semianalog/xmega-au-dev/renders/B_Cu.png

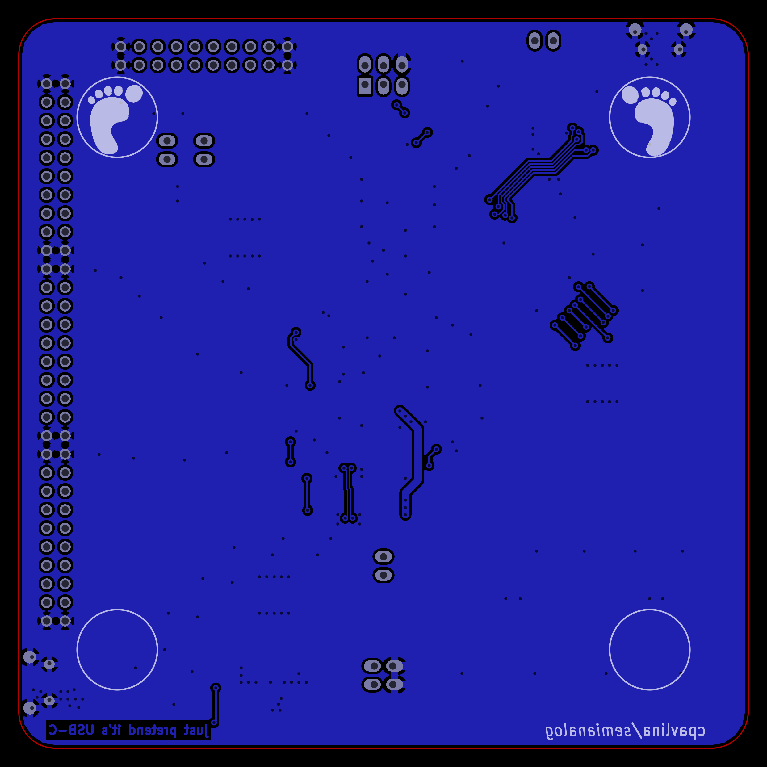
renders/B_Cu.png
