semianalog/xmega-au-dev/renders/F_Cu.png

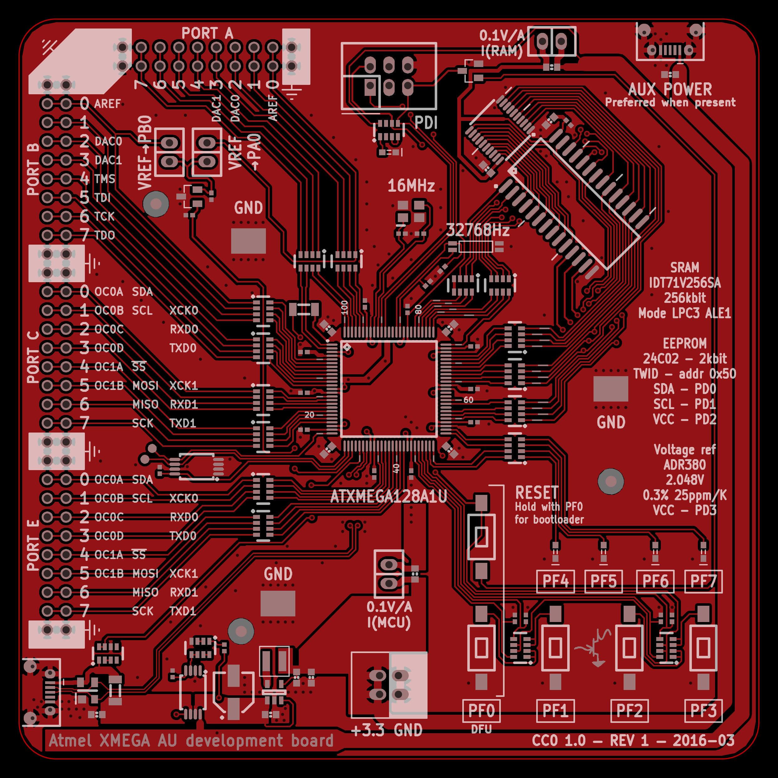
renders/F_Cu.png
