semianalog/xmega-au-dev/renders/Overview.png

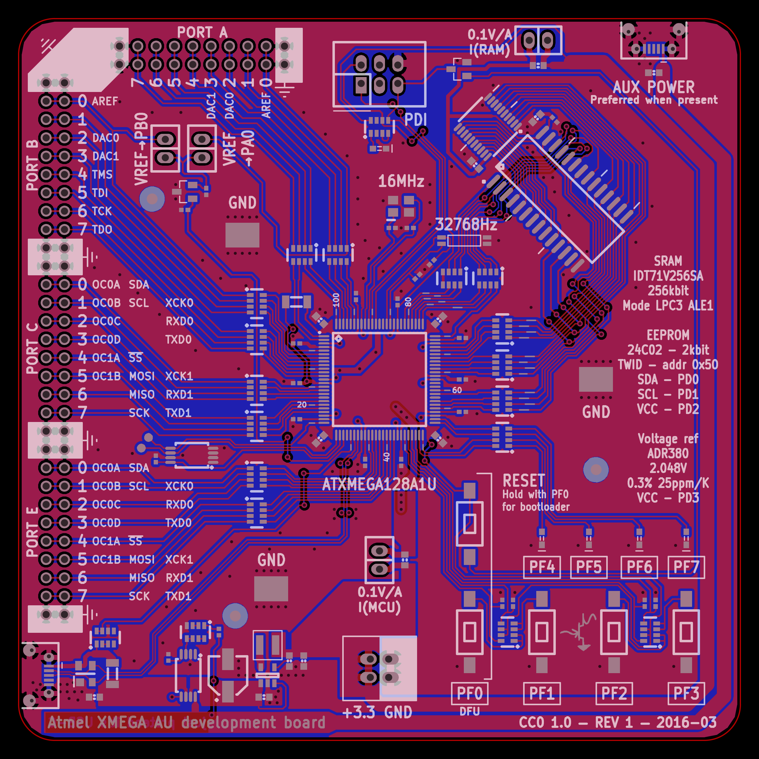
renders/Overview.png
