semianalog/xmega-au-dev/renders/Assembly.png

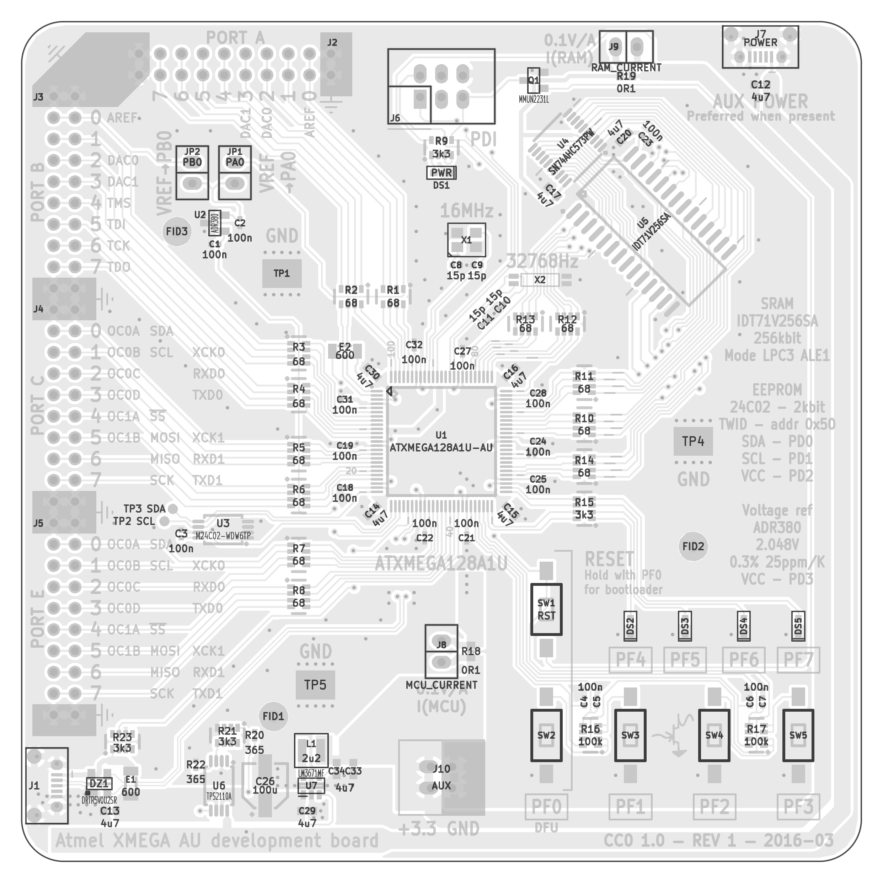
renders/Assembly.png
