semianalog/xmega-au-dev/renders/schematic.pdf

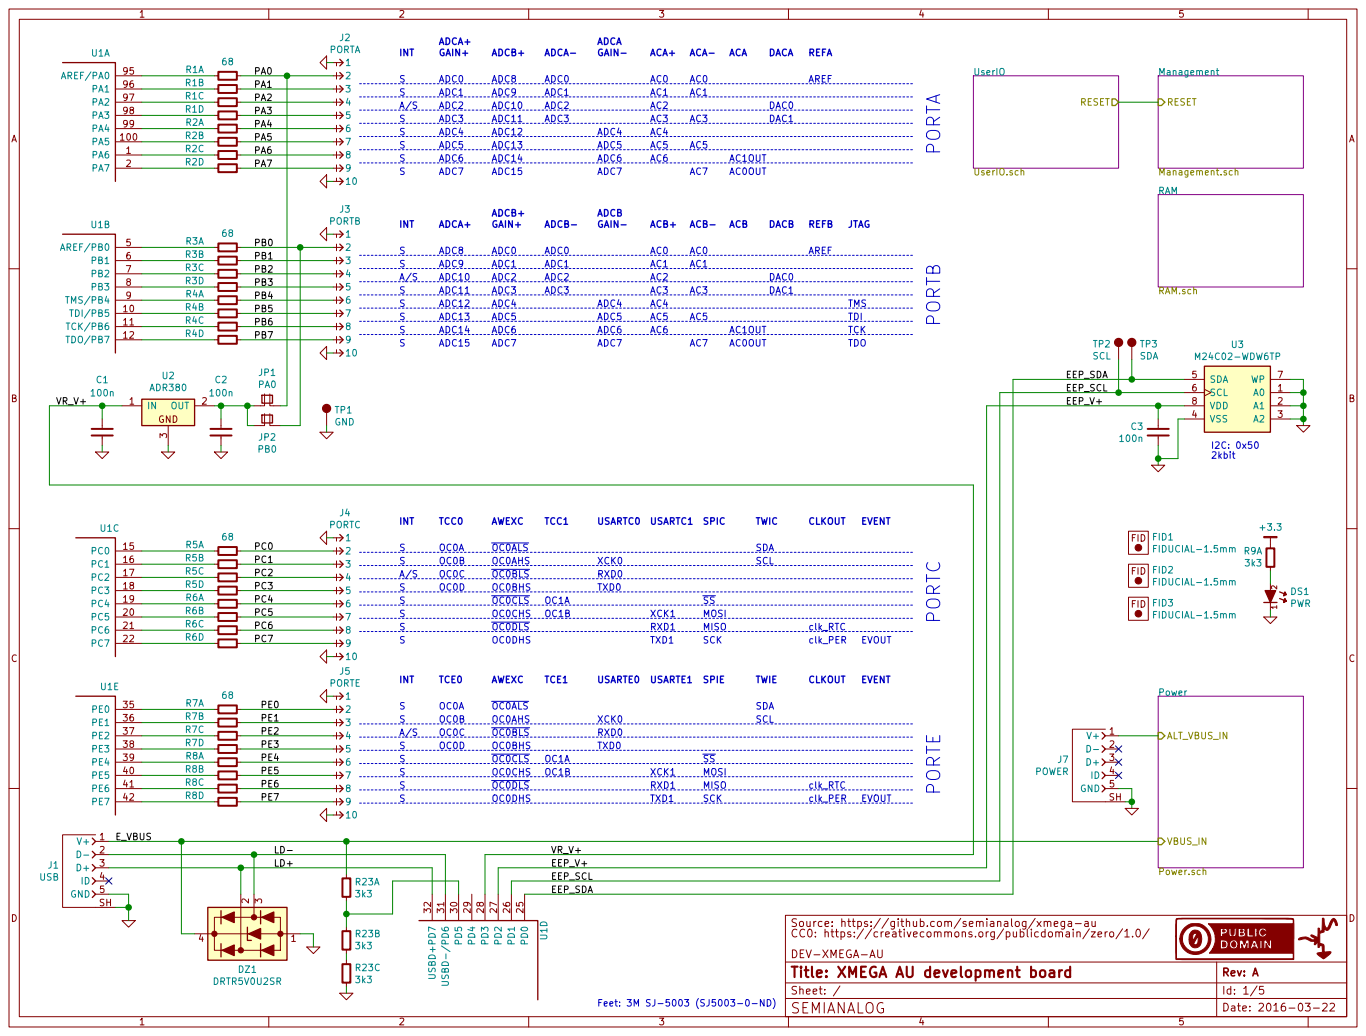
[picture p5: page 1]

Source: https://github.com/semianalog/xmega-au

Sheet: / DEV-XMEGA-AU

Id: 1/5 Title: XMEGA AU development board

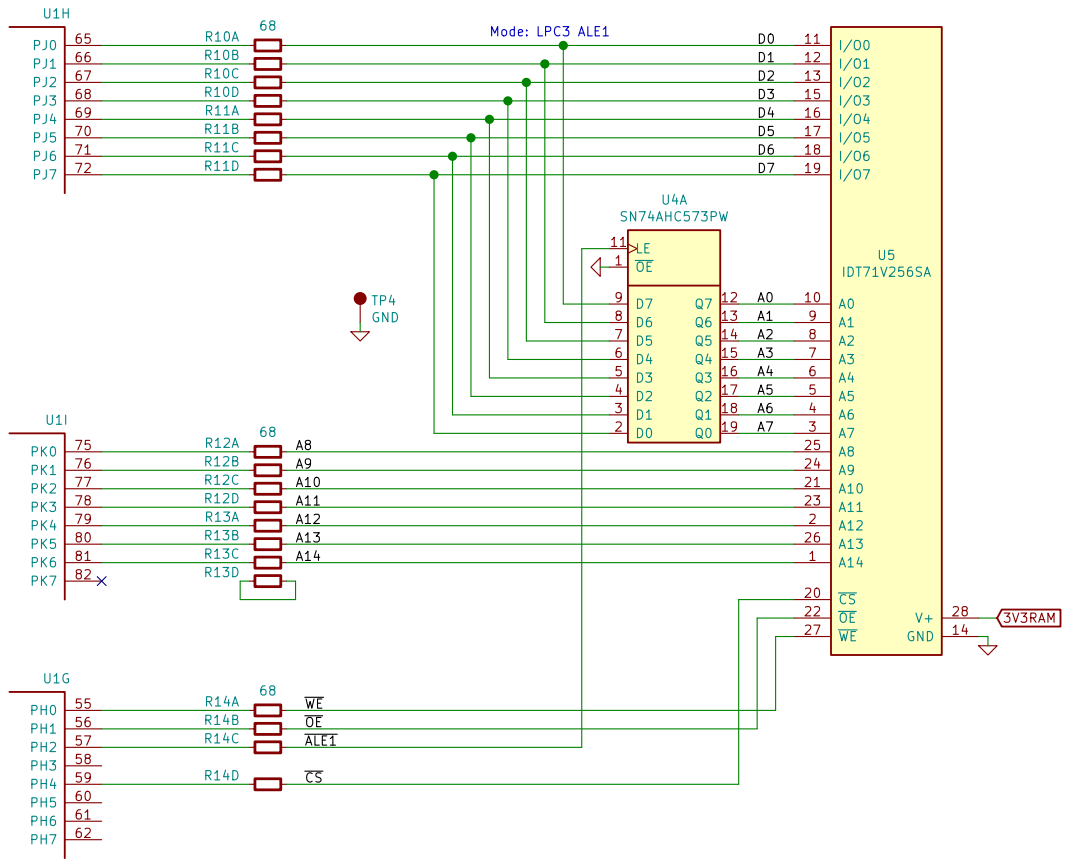
[picture p6: page 2]

Source: https://github.com/semianalog/xmega-au

Sheet: /RAM/ DEV-XMEGA-AU

Id: 2/5 Title: XMEGA AU development board

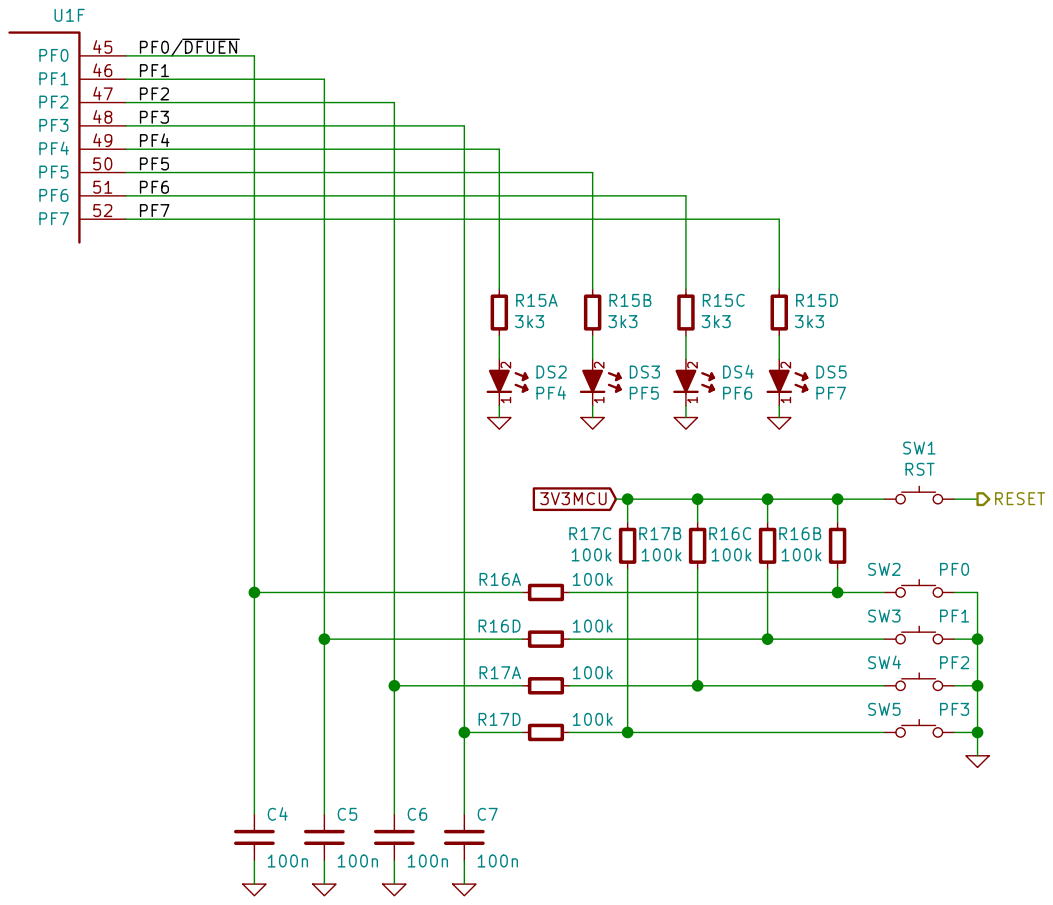
[picture p7: page 3]

Source: https://github.com/semianalog/xmega-au CC0: https://creativecommons.org/publicdomain/zero/1.0/

Sheet: /UserIO/ DEV-XMEGA-AU

Id: 3/5 Title: XMEGA AU development board

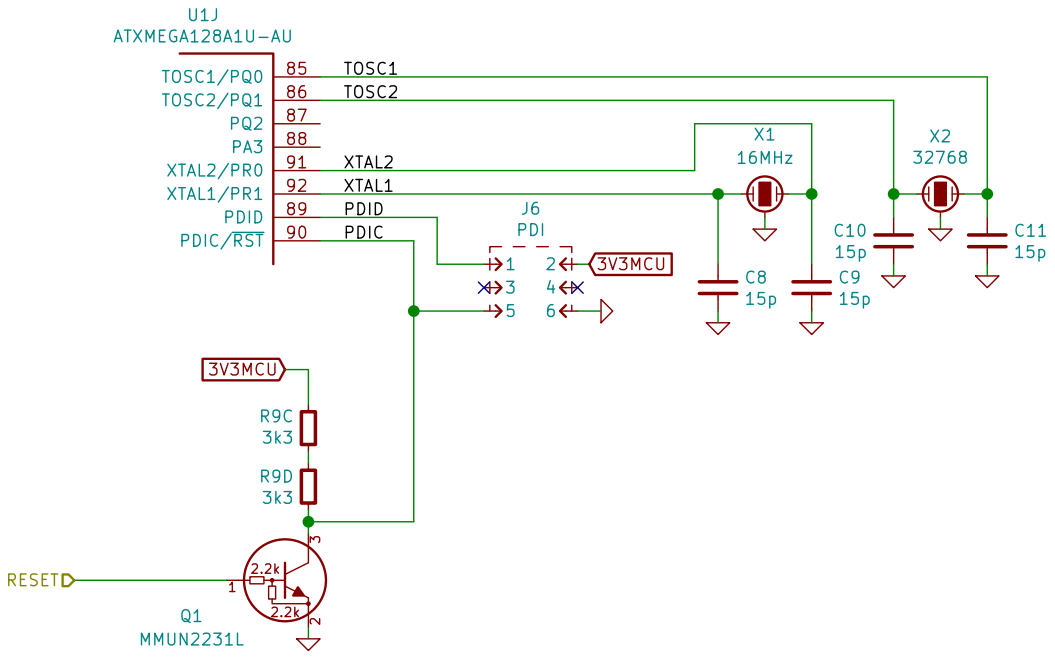
[picture p8: page 4]

Source: https://github.com/semianalog/xmega-au CC0: https://creativecommons.org/publicdomain/zero/1.0/

Sheet: /Management/ DEV-XMEGA-AU

Id: 4/5 Title: XMEGA AU development board

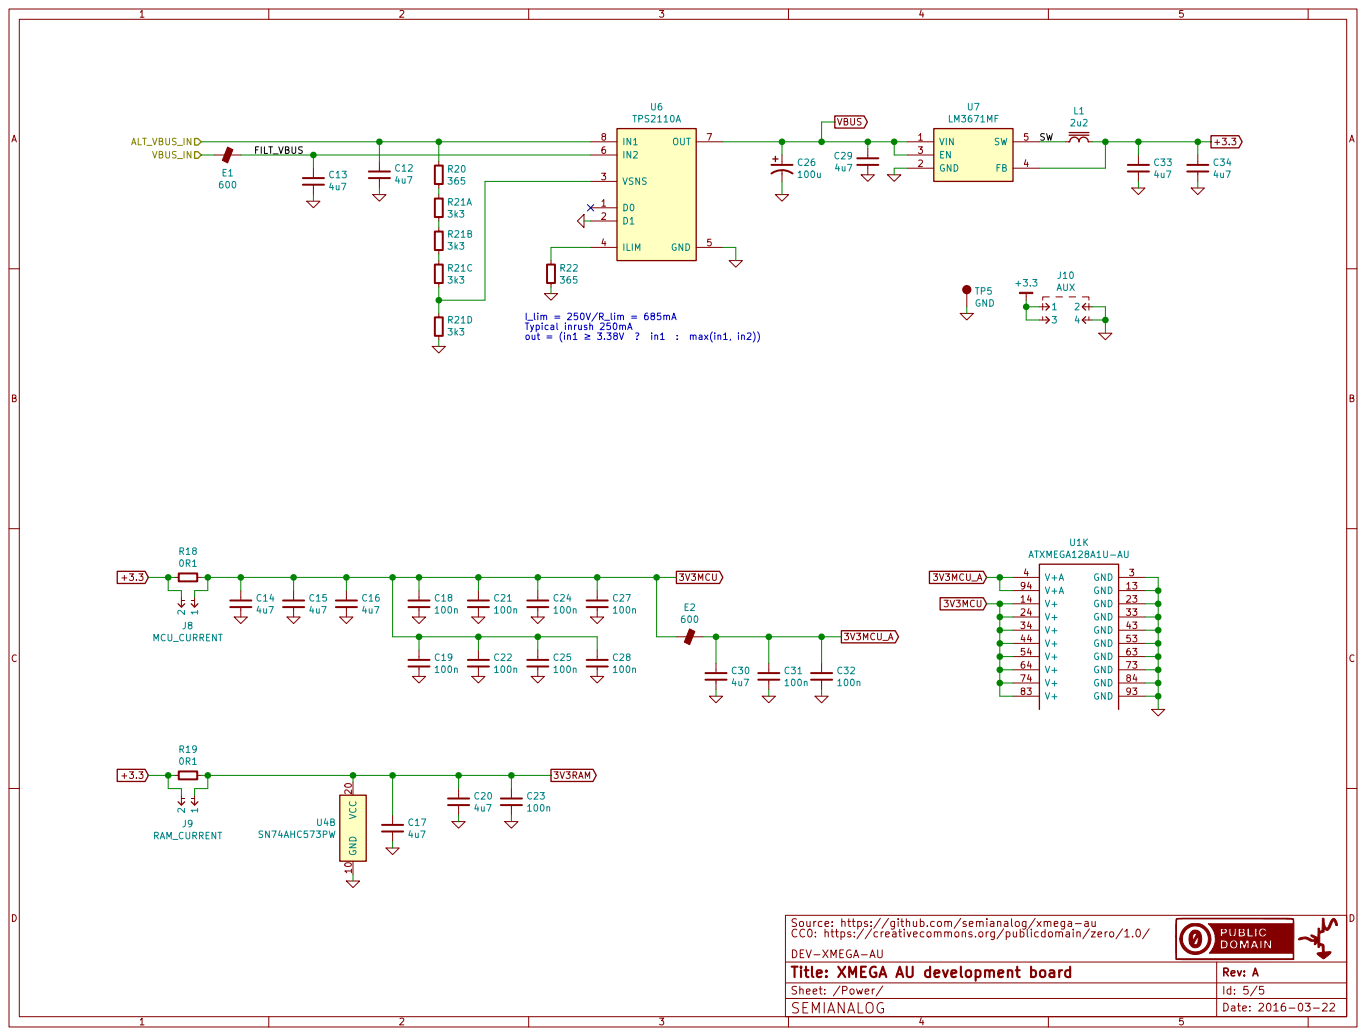
[picture p9: page 5]

Source: https://github.com/semianalog/xmega-au

Sheet: /Power/ DEV-XMEGA-AU

Id: 5/5 Title: XMEGA AU development board
