semianalog/xmega-au-dev/xmega.kicad_pcb

## KiCad design xmega.kicad_pcb (2016-03-23)

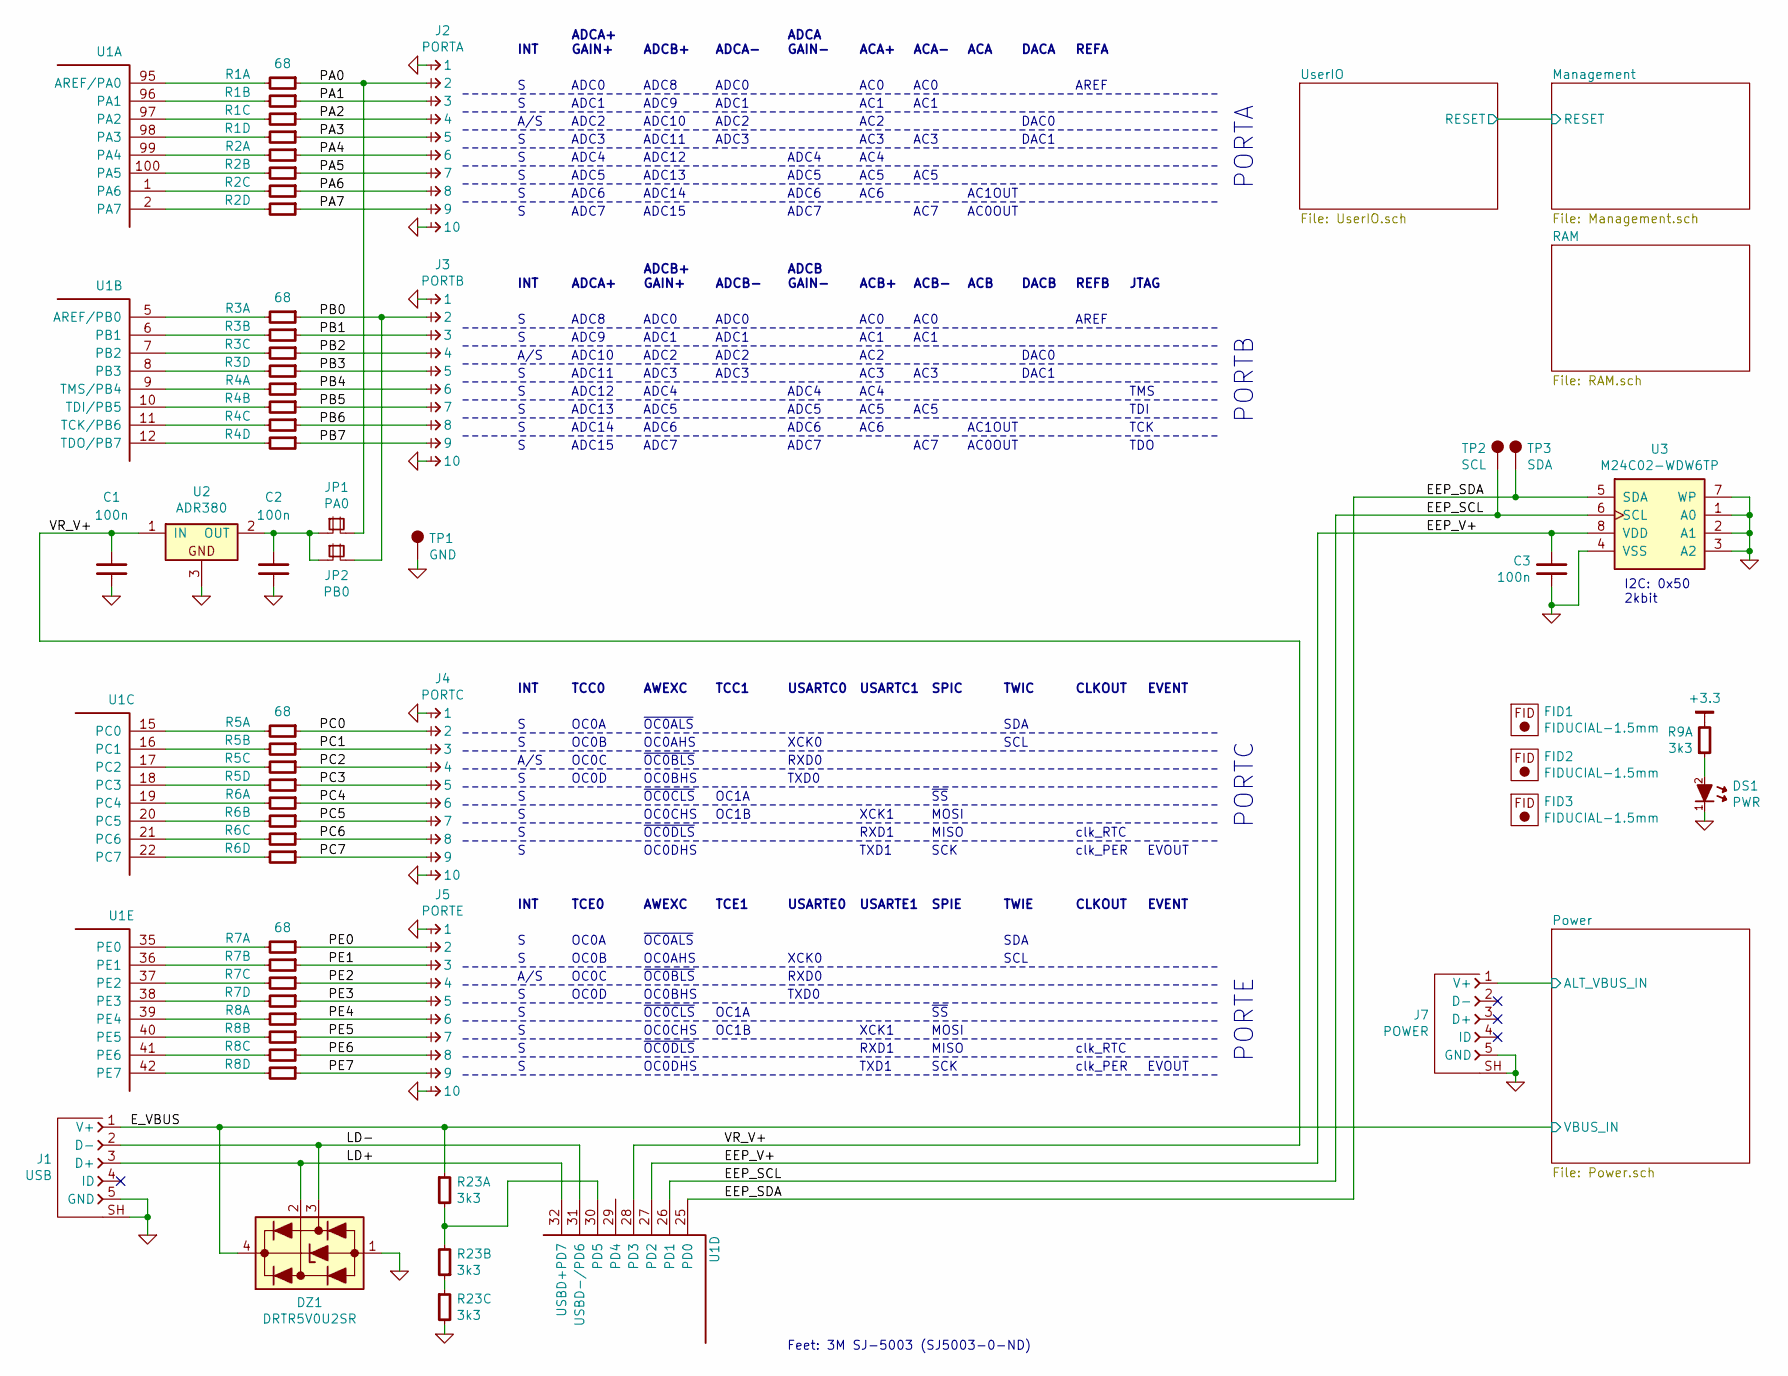
[picture p10: schematic xmega.sch, XMEGA AU development board]

Parts:
C1, C2, C3: 100n; CAPC1005X55
DS1: PWR; LED-0603
DZ1: DRTR5V0U2SR; SOT-143
FID1, FID2, FID3: FIDUCIAL-1.5mm
J1: USB; CONN-10118194-0001LF-FCI
J2: PORTA; CONN-100MIL-M-1x10
J3: PORTB; CONN-100MIL-M-1x10
J4: PORTC; CONN-100MIL-M-1x10
J5: PORTE; CONN-100MIL-M-1x10
J7: POWER; CONN-10118194-0001LF-FCI
JP1: PA0; CONN-100MIL-M-1x2
JP2: PB0; CONN-100MIL-M-1x2
R1, R2, R3, R4, R5, R6, R7, R8: 68; RESCAXE80P160X320X70-8
R9, R23: 3k3; RESCAXE80P160X320X70-8
TP1: GND; TESTPOINT-KEYSTONE-5018
TP2: SCL; TEST-SMD-SMALL
TP3: SDA; TEST-SMD-SMALL
U1: ATXMEGA128A1U-AU; QFP50P1600X1600X120-100
U2: ADR380; SOT-23
U3: M24C02-WDW6TP; SOP65P640X110-8

Connections:
+3.3: R9.8; also elsewhere on the board
/EEP_SCL: TP2.1, U1.26 (PD1), U3.6 (SCL)
/EEP_SDA: TP3.1, U1.25 (PD0), U3.5 (SDA)
/EEP_V+: C3.1, U1.27 (PD2), U3.8 (VDD)
/E_VBUS: DZ1.4, J1.1 (V+), R23.1; also elsewhere on the board
/LD+: DZ1.2, J1.3 (D+), U1.32 (USBD+PD7)
/LD-: DZ1.3, J1.2 (D-), U1.31 (USBD-/PD6)
/PA0: J2.2, JP1.2, R1.1
/PA1: J2.3, R1.2
/PA2: J2.4, R1.3
/PA3: J2.5, R1.4
/PA4: J2.6, R2.1
/PA5: J2.7, R2.2
/PA6: J2.8, R2.3
/PA7: J2.9, R2.4
/PB0: J3.2, JP2.2, R3.1
/PB1: J3.3, R3.2
/PB2: J3.4, R3.3
/PB3: J3.5, R3.4
/PB4: J3.6, R4.1
/PB5: J3.7, R4.2
/PB6: J3.8, R4.3
/PB7: J3.9, R4.4
/PC0: J4.2, R5.1
/PC1: J4.3, R5.2
/PC2: J4.4, R5.3
/PC3: J4.5, R5.4
/PC4: J4.6, R6.1
/PC5: J4.7, R6.2
/PC6: J4.8, R6.3
/PC7: J4.9, R6.4
/PE0: J5.2, R7.1
/PE1: J5.3, R7.2
/PE2: J5.4, R7.3
/PE3: J5.5, R7.4
/PE4: J5.6, R8.1
/PE5: J5.7, R8.2
/PE6: J5.8, R8.3
/PE7: J5.9, R8.4
/Power/ALT_VBUS_IN: J7.1 (V+); also elsewhere on the board
/VR_V+: C1.1, U1.28 (PD3), U2.1 (IN)
GND: C1.2, C2.2, C3.2, DS1.1 (K), DZ1.1, J1.5 (GND), J1.SH (SHIELD), J2.1, J2.10, J3.1, J3.10, J4.1, J4.10, J5.1, J5.10, J7.5 (GND), J7.SH (SHIELD), R23.6, TP1.1, U2.3, U3.1 (A0), U3.2 (A1), U3.3 (A2), U3.4 (VSS), U3.7 (WP); also elsewhere on the board
unnamed: C2.1, JP1.1, JP2.1, U2.2 (OUT)
unnamed: DS1.2 (A), R9.1
unnamed: R1.5, U1.98 (PA3)
unnamed: R1.6, U1.97 (PA2)
unnamed: R1.7, U1.96 (PA1)
unnamed: R1.8, U1.95 (AREF/PA0)
unnamed: R2.5, U1.2 (PA7)
unnamed: R2.6, U1.1 (PA6)
unnamed: R2.7, U1.100 (PA5)
unnamed: R2.8, U1.99 (PA4)
unnamed: R3.5, U1.8 (PB3)
unnamed: R3.6, U1.7 (PB2)
unnamed: R3.7, U1.6 (PB1)
unnamed: R3.8, U1.5 (AREF/PB0)
unnamed: R4.5, U1.12 (TDO/PB7)
unnamed: R4.6, U1.11 (TCK/PB6)
unnamed: R4.7, U1.10 (TDI/PB5)
unnamed: R4.8, U1.9 (TMS/PB4)
unnamed: R5.5, U1.18 (PC3)
unnamed: R5.6, U1.17 (PC2)
unnamed: R5.7, U1.16 (PC1)
unnamed: R5.8, U1.15 (PC0)
unnamed: R6.5, U1.22 (PC7)
unnamed: R6.6, U1.21 (PC6)
unnamed: R6.7, U1.20 (PC5)
unnamed: R6.8, U1.19 (PC4)
unnamed: R7.5, U1.38 (PE3)
unnamed: R7.6, U1.37 (PE2)
unnamed: R7.7, U1.36 (PE1)
unnamed: R7.8, U1.35 (PE0)
unnamed: R8.5, U1.42 (PE7)
unnamed: R8.6, U1.41 (PE6)
unnamed: R8.7, U1.40 (PE5)
unnamed: R8.8, U1.39 (PE4)
unnamed: R23.2, R23.3
unnamed: R23.7, R23.8, U1.30 (PD5)

Notes on the sheet:
I2C: 0x50 2kbit
Feet: 3M SJ-5003 (SJ5003-0-ND)
INT
A/S
TCC0
AWEXC
TCC1
USARTC0
USARTC1
SPIC
TWIC
CLKOUT
EVENT
OC0A
OC0B
OC0C
OC0D
~OC0ALS
OC0AHS
~OC0BLS
OC0BHS
~OC0CLS
OC0CHS
~OC0DLS
OC0DHS
OC1A
OC1B
XCK0
RXD0
TXD0
XCK1
RXD1
TXD1
SDA
SCL
~SS
MOSI
MISO
SCK
clk_RTC
clk_PER
EVOUT
TCE0
TCE1
USARTE0
USARTE1
SPIE
TWIE
PORTC
PORTE
ADCA+ GAIN+
ADCB+
ADCA-
ADCA GAIN-
ACA+
ACA-
ACA
DACA
REFA
ADC0
ADC1
ADC2
ADC3
ADC4
ADC5
ADC6
ADC7
ADC8
ADC9
ADC10
ADC11
ADC12
ADC13
ADC14
ADC15
AC0
AC1
AC2
AC3
AC4
AC5
AC6
AC7
AC1OUT
AC0OUT
DAC0
DAC1
AREF
ADCA+
ADCB+ GAIN+
ADCB-
ADCB GAIN-
ACB+
ACB-
ACB
DACB
REFB
JTAG
TMS
TDI
TCK
TDO
PORTA
PORTB

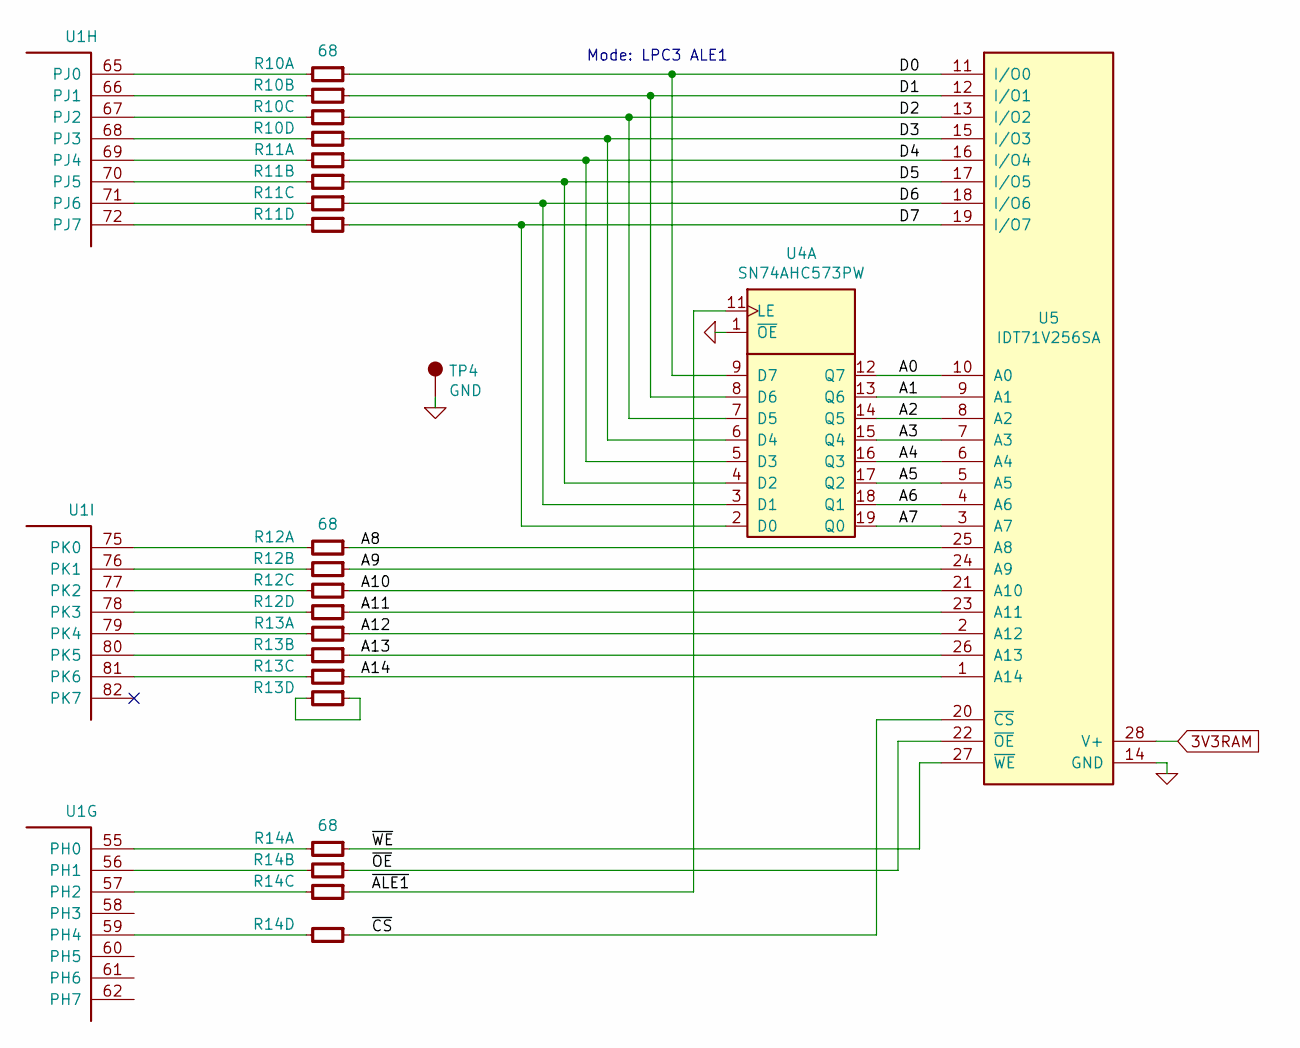
[picture p11: schematic RAM.sch, XMEGA AU development board]

Parts:
R10, R11, R12, R13, R14: 68; RESCAXE80P160X320X70-8
TP4: GND; TESTPOINT-KEYSTONE-5018
U1: ATXMEGA128A1U-AU; QFP50P1600X1600X120-100
U4: SN74AHC573PW; SOP65P640X110-20
U5: IDT71V256SA; SOJ127P1118X375-28

Connections:
3V3RAM: U5.28 (V+); also elsewhere on the board
/RAM/A0: U4.12 (Q7), U5.10 (A0)
/RAM/A1: U4.13 (Q6), U5.9 (A1)
/RAM/A2: U4.14 (Q5), U5.8 (A2)
/RAM/A3: U4.15 (Q4), U5.7 (A3)
/RAM/A4: U4.16 (Q3), U5.6 (A4)
/RAM/A5: U4.17 (Q2), U5.5 (A5)
/RAM/A6: U4.18 (Q1), U5.4 (A6)
/RAM/A7: U4.19 (Q0), U5.3 (A7)
/RAM/A8: R12.1, U5.25 (A8)
/RAM/A9: R12.2, U5.24 (A9)
/RAM/A10: R12.3, U5.21 (A10)
/RAM/A11: R12.4, U5.23 (A11)
/RAM/A12: R13.1, U5.2 (A12)
/RAM/A13: R13.2, U5.26 (A13)
/RAM/A14: R13.3, U5.1 (A14)
/RAM/D0: R10.1, U4.9 (D7), U5.11 (I/O0)
/RAM/D1: R10.2, U4.8 (D6), U5.12 (I/O1)
/RAM/D2: R10.3, U4.7 (D5), U5.13 (I/O2)
/RAM/D3: R10.4, U4.6 (D4), U5.15 (I/O3)
/RAM/D4: R11.1, U4.5 (D3), U5.16 (I/O4)
/RAM/D5: R11.2, U4.4 (D2), U5.17 (I/O5)
/RAM/D6: R11.3, U4.3 (D1), U5.18 (I/O6)
/RAM/D7: R11.4, U4.2 (D0), U5.19 (I/O7)
/RAM/~ALE1: R14.3, U4.11 (LE)
/RAM/~CS: R14.4, U5.20 (~CS)
/RAM/~OE: R14.2, U5.22 (~OE)
/RAM/~WE: R14.1, U5.27 (~WE)
GND: TP4.1, U4.1 (~OE), U5.14 (GND); also elsewhere on the board
unnamed: R10.5, U1.68 (PJ3)
unnamed: R10.6, U1.67 (PJ2)
unnamed: R10.7, U1.66 (PJ1)
unnamed: R10.8, U1.65 (PJ0)
unnamed: R11.5, U1.72 (PJ7)
unnamed: R11.6, U1.71 (PJ6)
unnamed: R11.7, U1.70 (PJ5)
unnamed: R11.8, U1.69 (PJ4)
unnamed: R12.5, U1.78 (PK3)
unnamed: R12.6, U1.77 (PK2)
unnamed: R12.7, U1.76 (PK1)
unnamed: R12.8, U1.75 (PK0)
unnamed: R13.4, R13.5
unnamed: R13.6, U1.81 (PK6)
unnamed: R13.7, U1.80 (PK5)
unnamed: R13.8, U1.79 (PK4)
unnamed: R14.5, U1.59 (PH4)
unnamed: R14.6, U1.57 (PH2)
unnamed: R14.7, U1.56 (PH1)
unnamed: R14.8, U1.55 (PH0)

Notes on the sheet:
Mode: LPC3 ALE1

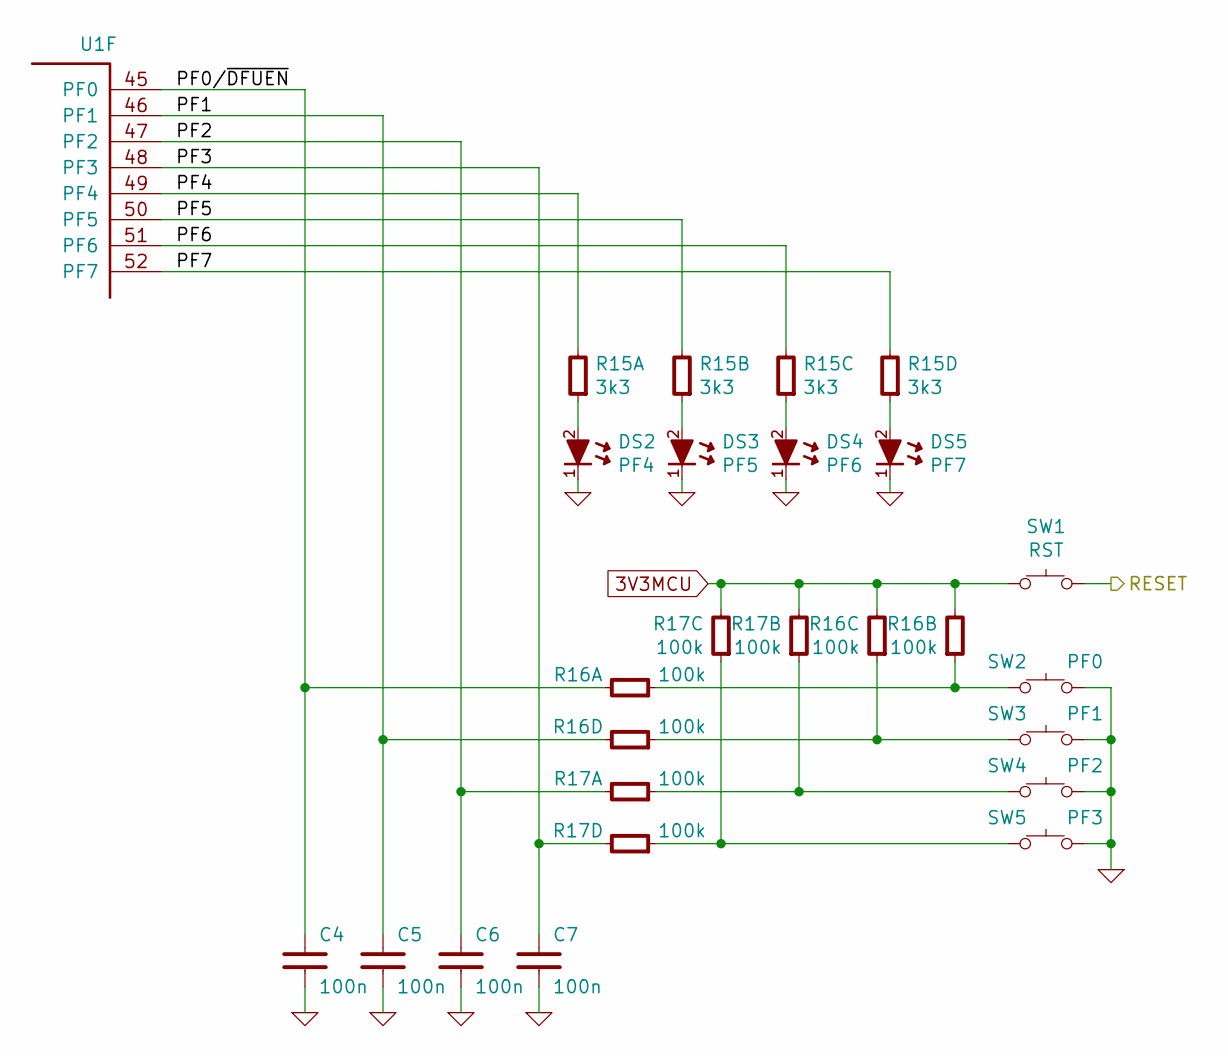
[picture p12: schematic UserIO.sch, XMEGA AU development board]

Parts:
C4, C5, C6, C7: 100n; CAPC1005X55
DS2: PF4; LED-0603
DS3: PF5; LED-0603
DS4: PF6; LED-0603
DS5: PF7; LED-0603
R15: 3k3; RESCAXE80P160X320X70-8
R16, R17: 100k; RESCAXE80P160X320X70-8
SW1: RST; TE-FSMSM
SW2: PF0; TE-FSMSM
SW3: PF1; TE-FSMSM
SW4: PF2; TE-FSMSM
SW5: PF3; TE-FSMSM
U1: ATXMEGA128A1U-AU; QFP50P1600X1600X120-100

Connections:
3V3MCU: R16.6, R16.7, R17.6, R17.7, SW1.1; also elsewhere on the board
/Management/RESET: SW1.2; also elsewhere on the board
/UserIO/PF0/~DFUEN: C4.1, R16.8, U1.45 (PF0)
/UserIO/PF1: C5.1, R16.5, U1.46 (PF1)
/UserIO/PF2: C6.1, R17.8, U1.47 (PF2)
/UserIO/PF3: C7.1, R17.5, U1.48 (PF3)
/UserIO/PF4: R15.8, U1.49 (PF4)
/UserIO/PF5: R15.7, U1.50 (PF5)
/UserIO/PF6: R15.6, U1.51 (PF6)
/UserIO/PF7: R15.5, U1.52 (PF7)
GND: C4.2, C5.2, C6.2, C7.2, DS2.1 (K), DS3.1 (K), DS4.1 (K), DS5.1 (K), SW2.2, SW3.2, SW4.2, SW5.2; also elsewhere on the board
unnamed: DS2.2 (A), R15.1
unnamed: DS3.2 (A), R15.2
unnamed: DS4.2 (A), R15.3
unnamed: DS5.2 (A), R15.4
unnamed: R16.1, R16.2, SW2.1
unnamed: R16.3, R16.4, SW3.1
unnamed: R17.1, R17.2, SW4.1
unnamed: R17.3, R17.4, SW5.1

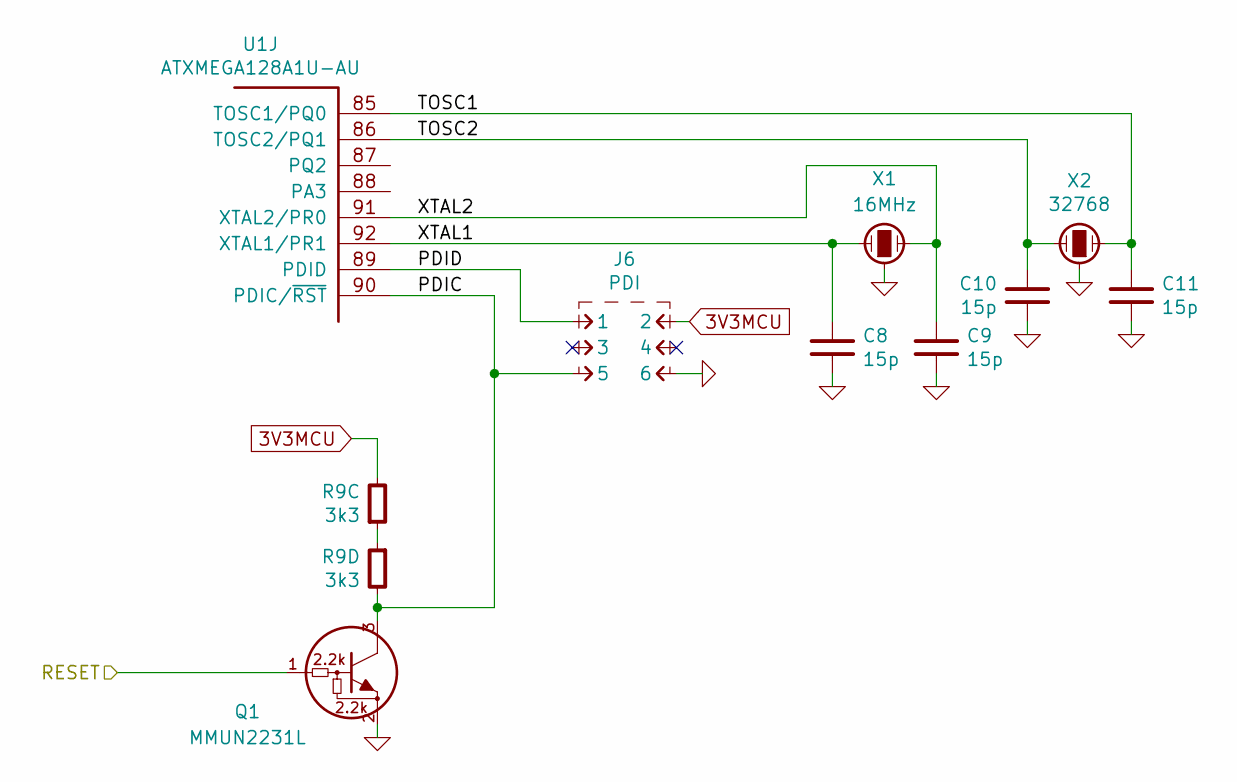
[picture p13: schematic Management.sch, XMEGA AU development board]

Parts:
C8, C9, C10, C11: 15p; CAPC1005X55
J6: PDI; CONN-100MIL-M-2x3-SHROUD
Q1: MMUN2231L; SOT-23
R9: 3k3; RESCAXE80P160X320X70-8
U1: ATXMEGA128A1U-AU; QFP50P1600X1600X120-100
X1: 16MHz; ABRACON-ABM8G
X2: 32768

Connections:
3V3MCU: J6.2, R9.6; also elsewhere on the board
/Management/PDIC: J6.5, Q1.3 (C), R9.5, U1.90 (PDIC/~RST)
/Management/PDID: J6.1, U1.89 (PDID)
/Management/RESET: Q1.1 (B); also elsewhere on the board
/Management/TOSC1: C11.1, U1.85 (TOSC1/PQ0), X2.1
/Management/TOSC2: C10.1, U1.86 (TOSC2/PQ1), X2.2
/Management/XTAL1: C8.1, U1.92 (XTAL1/PR1), X1.1
/Management/XTAL2: C9.1, U1.91 (XTAL2/PR0), X1.2
GND: C8.2, C9.2, C10.2, C11.2, J6.6, Q1.2 (E), X1.3, X2.3; also elsewhere on the board
unnamed: R9.3, R9.4

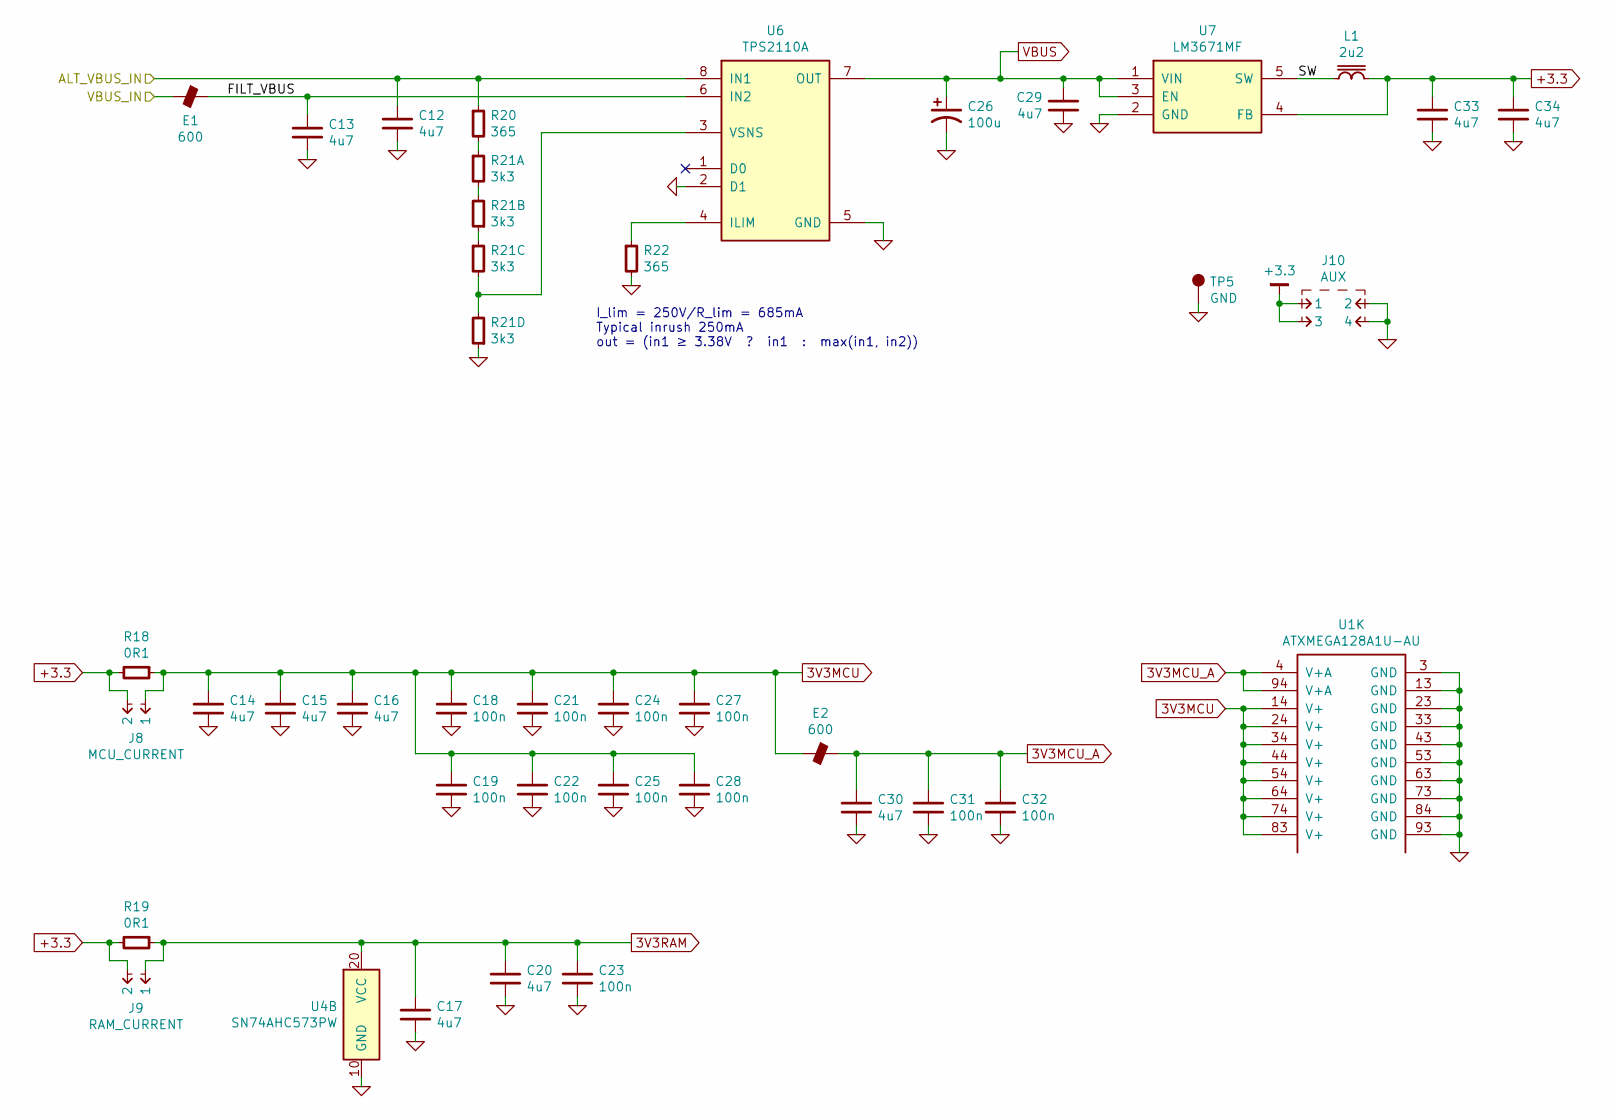
[picture p14: schematic Power.sch, XMEGA AU development board]

Parts:
C12, C13, C14, C15, C16, C17, C20, C29, C30, C33, C34: 4u7; CAPC1608X55
C18, C19, C21, C22, C23, C24, C25, C27, C28, C31, C32: 100n; CAPC1005X55
C26: 100u; CAPAE530X540
E1, E2: 600; RESC3216X60
J8: MCU_CURRENT; CONN-100MIL-M-1x2
J9: RAM_CURRENT; CONN-100MIL-M-1x2
J10: AUX; CONN-100MIL-M-2x2
L1: 2u2; BOURNS-SRN3015
R18, R19: 0R1; RESC1608X50
R20, R22: 365; RESC1005X40
R21: 3k3; RESCAXE80P160X320X70-8
TP5: GND; TESTPOINT-KEYSTONE-5018
U1: ATXMEGA128A1U-AU; QFP50P1600X1600X120-100
U4: SN74AHC573PW; SOP65P640X110-20
U6: TPS2110A; SOP65P640X110-8
U7: LM3671MF; SOT-23-5

Connections:
3V3MCU: C14.1, C15.1, C16.1, C18.1, C19.1, C21.1, C22.1, C24.1, C25.1, C27.1, C28.1, E2.1, J8.1, R18.1, U1.14 (V+), U1.24 (V+), U1.34 (V+), U1.44 (V+), U1.54 (V+), U1.64 (V+), U1.74 (V+), U1.83 (V+); also elsewhere on the board
3V3MCU_A: C30.1, C31.1, C32.1, E2.2, U1.4 (V+A), U1.94 (V+A)
3V3RAM: C17.1, C20.1, C23.1, J9.1, R19.1, U4.20 (VCC); also elsewhere on the board
+3.3: C33.1, C34.1, J8.2, J9.2, J10.1, J10.3, L1.1, R18.2, R19.2, U7.4 (FB); also elsewhere on the board
/E_VBUS: E1.1; also elsewhere on the board
/Power/ALT_VBUS_IN: C12.2, R20.1, U6.8 (IN1); also elsewhere on the board
/Power/FILT_VBUS: C13.2, E1.2, U6.6 (IN2)
/Power/SW: L1.2, U7.5 (SW)
GND: C12.1, C13.1, C14.2, C15.2, C16.2, C17.2, C18.2, C19.2, C20.2, C21.2, C22.2, C23.2, C24.2, C25.2, C26.2, C27.2, C28.2, C29.2, C30.2, C31.2, C32.2, C33.2, C34.2, J10.2, J10.4, R21.4, R22.2, TP5.1, U1.3 (GND), U1.13 (GND), U1.23 (GND), U1.33 (GND), U1.43 (GND), U1.53 (GND), U1.63 (GND), U1.73 (GND), U1.84 (GND), U1.93 (GND), U4.10 (GND), U6.2 (D1), U6.5 (GND), U7.2 (GND); also elsewhere on the board
unnamed: R20.2, R21.1
unnamed: R21.2, R21.3
unnamed: R21.5, R21.6, U6.3 (VSNS)
unnamed: R21.7, R21.8
unnamed: R22.1, U6.4 (ILIM)
VBUS: C26.1, C29.1, U6.7 (OUT), U7.1 (VIN), U7.3 (EN)

Notes on the sheet:
I_lim = 250V/R_lim = 685mA Typical inrush 250mA out = (in1 ≥ 3.38V ? in1 : max(in1, in2))

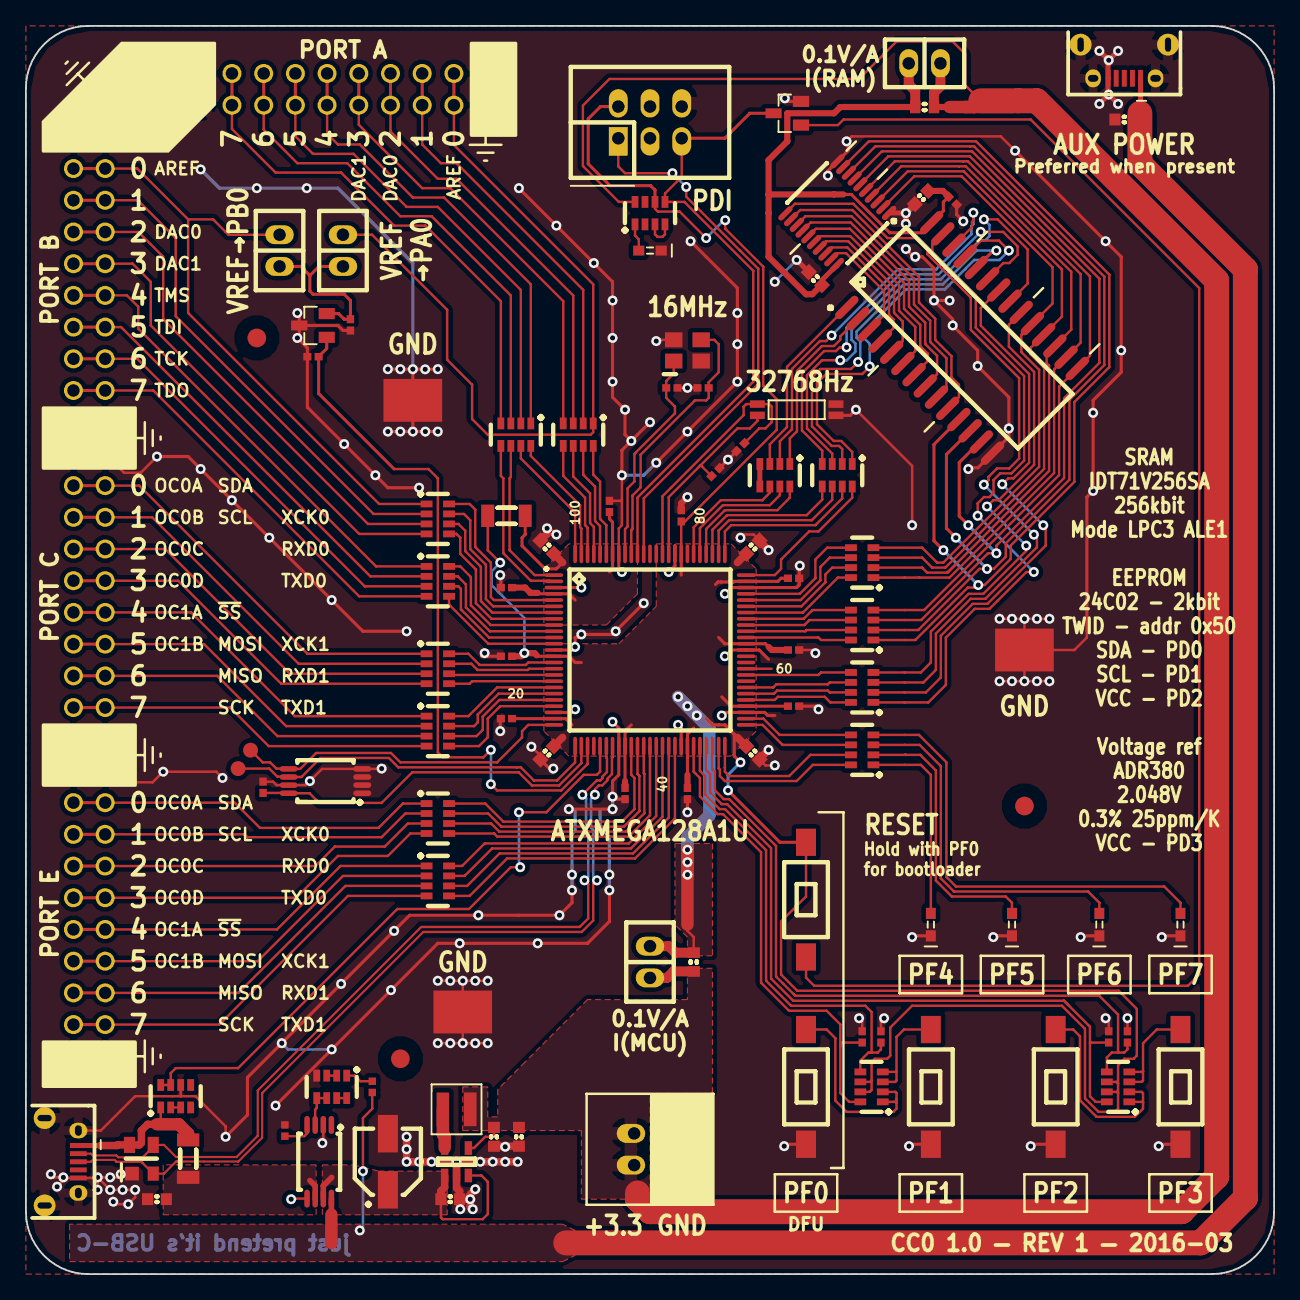
[picture p15: board xmega.kicad_pcb from above]

Board: 2 copper layers, 100.0 x 100.0 mm, 101 parts (0 on the bottom side), 160 nets.
