semianalog/xmega-au-dev/(commit log)

2016-03-22 Schematic tidy-ups and add VBUS sense
    [Management.sch, Power.sch, RAM.sch, UserIO.sch, xmega.kicad_pcb, xmega.sch]
2016-03-22 Fix VBUS sense circuit
    Voltage delivered with 2x(3k3) divider was too low, switch to 3x(3k3)
    [xmega.kicad_pcb, xmega.sch]
2016-03-22 Rearrange Power schematic a bit
    [Power.sch]
2016-03-22 Edit back silkscreen
    [xmega.kicad_pcb]
2016-03-22 Final PCB adjustment, DRC, and gerber rendering
    [xmega.kicad_pcb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]
2016-03-22 Prepare BOM for ordering
    [bom.csv]
2016-03-23 Adjust F.Fab layer as assembly diagram
    [xmega.kicad_pcb]
2016-03-23 Add assembly diagram
    [xmega.kicad_pcb]
