semianalog/xmega-au-dev/(notices)

Notices in the files:
xmega.kicad_pcb:
CC0 1.0 — REV 1 — 2016-03
